tgreen-fe/so101-legs/hip_roll_v2.SLDPRT

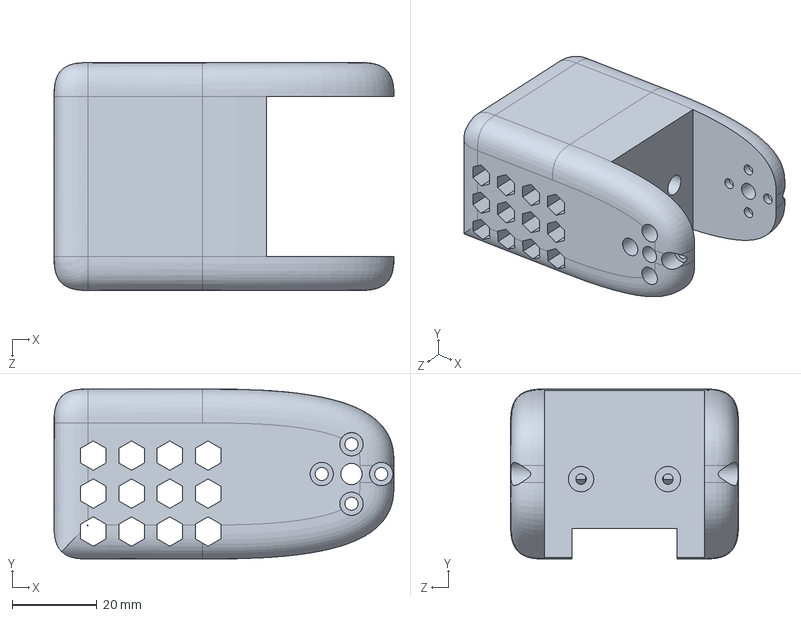
[picture p1: CAD file, 2026-09-14]
hip_roll_v2.SLDPRT
80.0 x 40.0 x 53.6 mm
