tgreen-fe/so101-legs/v3/mujoco/meshes/thigh_L_printed.stl

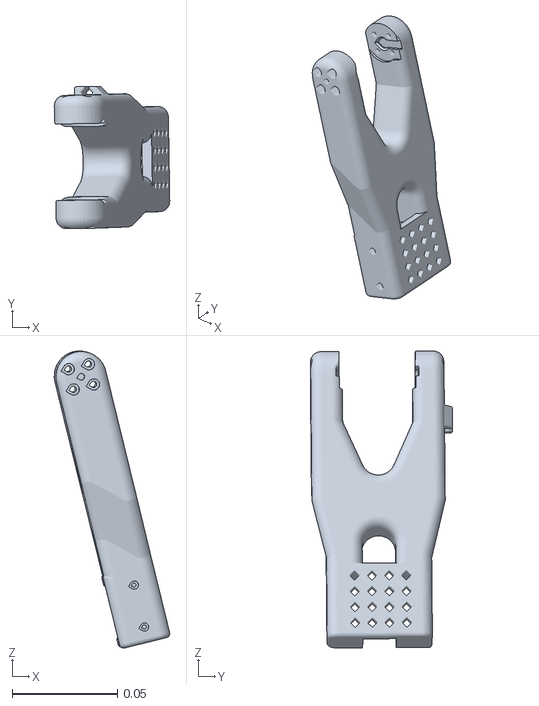
[picture p2: CAD file, 2026-11-03]
v3/mujoco/meshes/thigh_L_printed.stl
0.0549 x 0.0677 x 0.141
