tgreen-fe/so101-legs/v3/parts/leg_lower_v3.SLDPRT

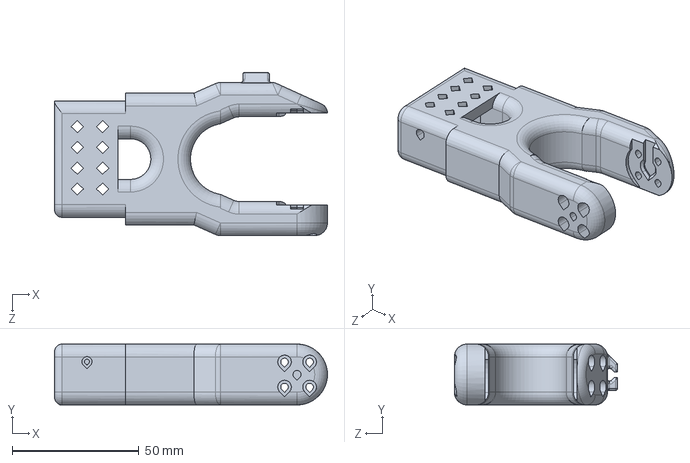
[picture p3: CAD file, 2026-11-03]
v3/parts/leg_lower_v3.SLDPRT
107.7 x 24.0 x 64.4 mm
