tgreen-fe/so101-legs/v3/pelvis_v3.SLDPRT

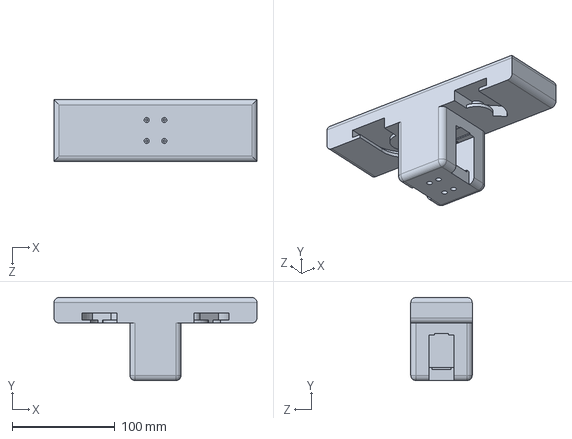
[picture p4: CAD file, 2026-11-03]
v3/pelvis_v3.SLDPRT
198.0 x 81.0 x 60.0 mm
