tgreen-fe/so101-legs/v3/stl/sim/upper_leg.STL

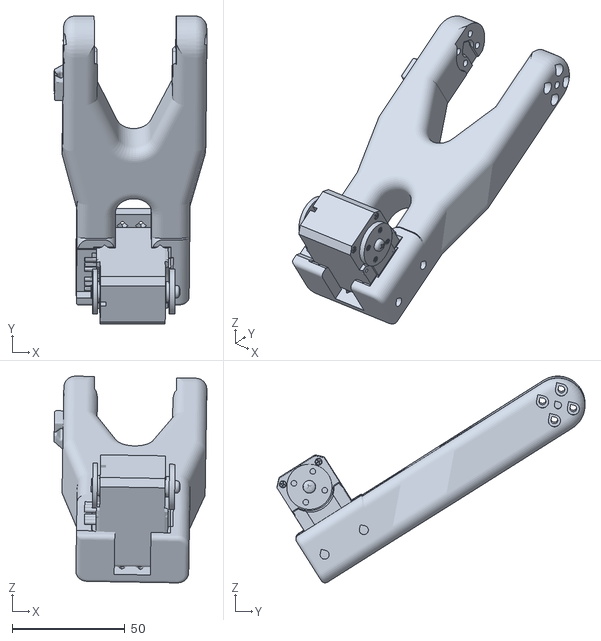
[picture p5: CAD file, 2026-11-03]
v3/stl/sim/upper_leg.STL
67.7 x 136.4 x 91.6
