tgreen-fe/so101-legs/v3/mujoco/meshes/hip_L_servo.stl

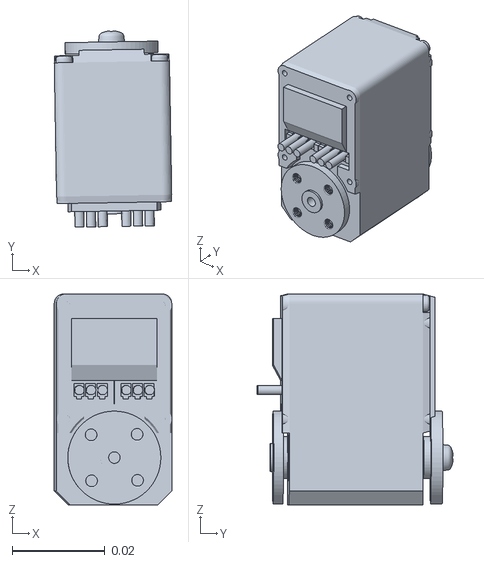
[picture p6: CAD file, 2026-11-03]
v3/mujoco/meshes/hip_L_servo.stl
0.0253 x 0.0423 x 0.0454
