tgreen-fe/so101-legs/v3/parts/hip_yaw_v3.SLDPRT

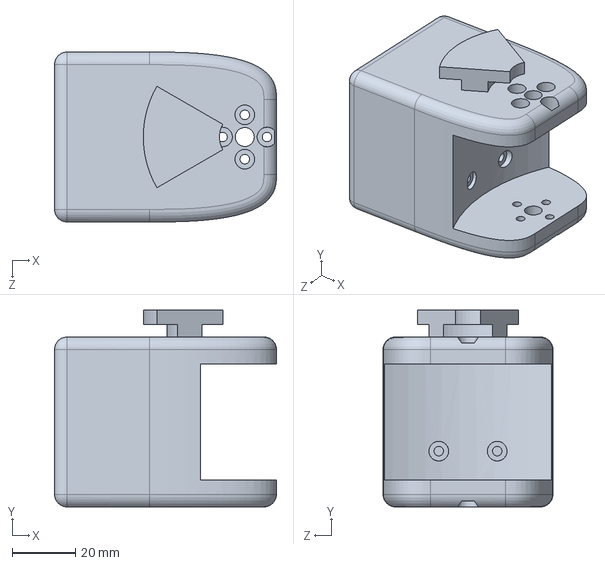
[picture p7: CAD file, 2026-11-03]
v3/parts/hip_yaw_v3.SLDPRT
70.0 x 62.1 x 53.6 mm
