tgreen-fe/so101-legs/v3/stl/sim/foot.STL

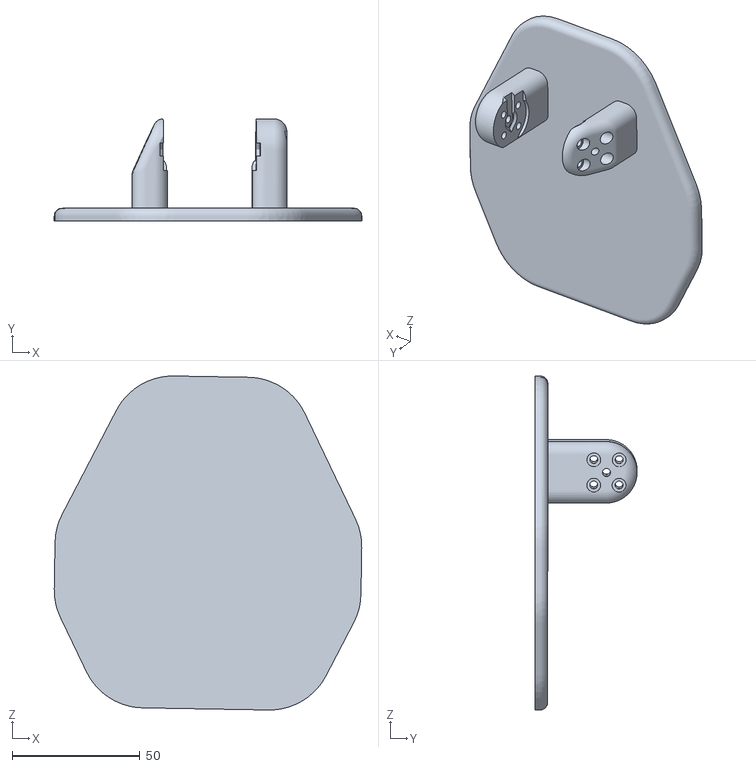
[picture p8: CAD file, 2026-11-03]
v3/stl/sim/foot.STL
120.3 x 40.0 x 130.6
