tgreen-fe/so101-legs/servo-motor_sts3215-v10.step

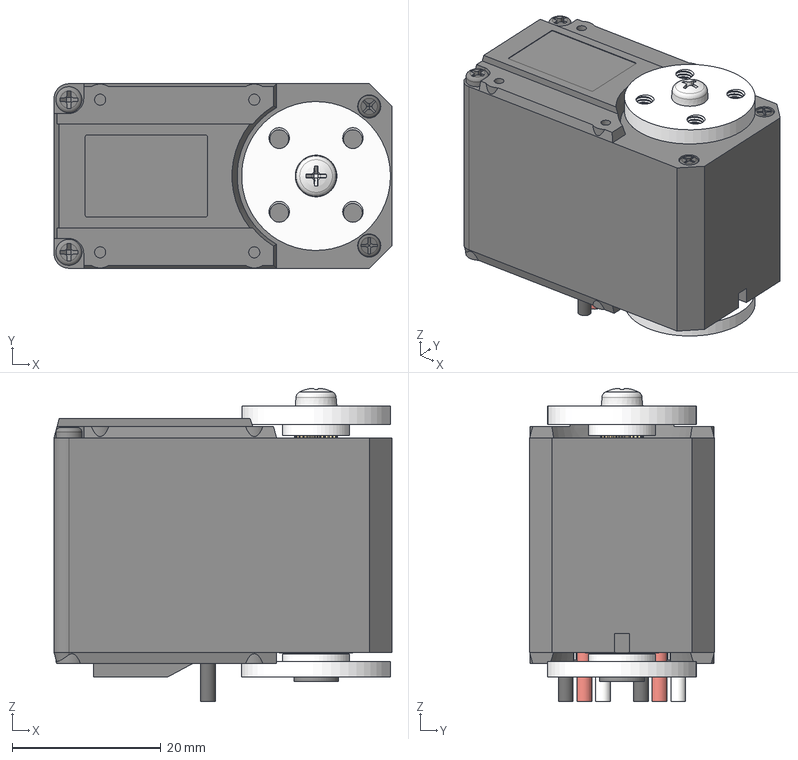
[picture p9: CAD file, 2026-09-14]
servo-motor_sts3215-v10.step
45.4 x 24.8 x 42.1 mm
Composant2
Composant3
Composant4
vis x 2
connector F x 2
PHS JIS B 1111 - M3 x 4 - H Acier inoxydable A2 Standard
