tgreen-fe/so101-legs/v3/mujoco/meshes/pelvis_servo.stl

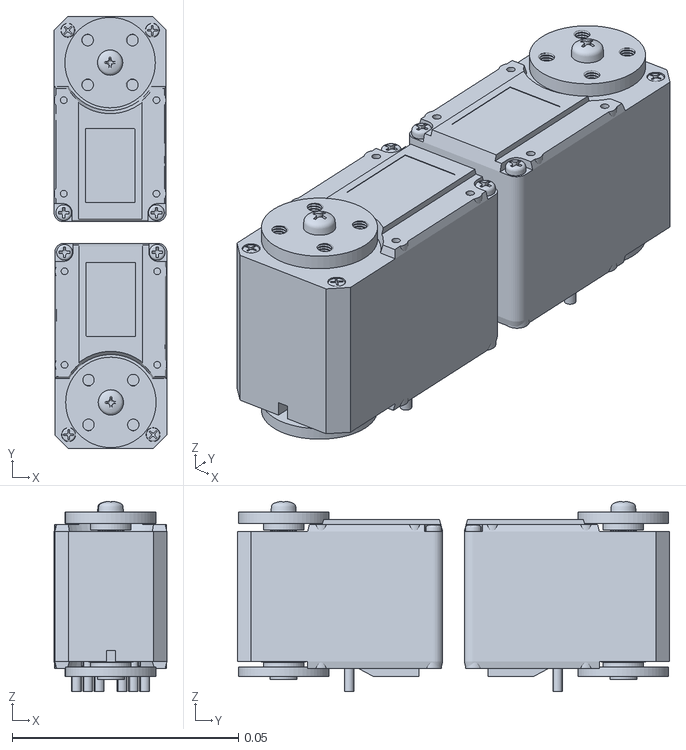
[picture p10: CAD file, 2026-11-03]
v3/mujoco/meshes/pelvis_servo.stl
0.025 x 0.0956 x 0.0421
