tgreen-fe/so101-legs/v3/stl/sim/lower_leg.STL

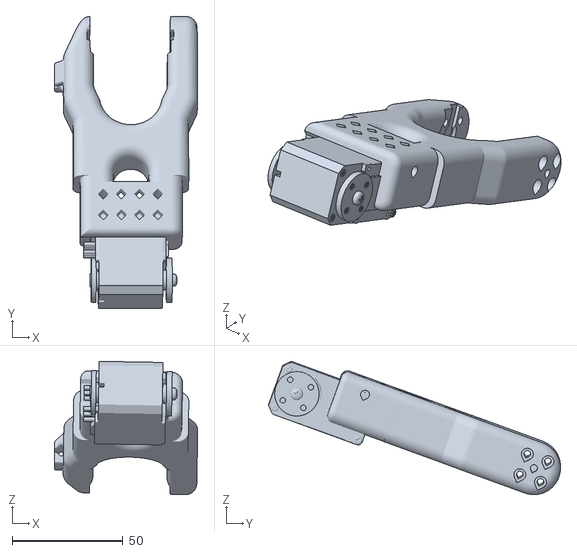
[picture p11: CAD file, 2026-11-03]
v3/stl/sim/lower_leg.STL
64.7 x 131.7 x 60.2
