tgreen-fe/so101-legs/v3/mujoco/meshes/foot_L_printed.stl

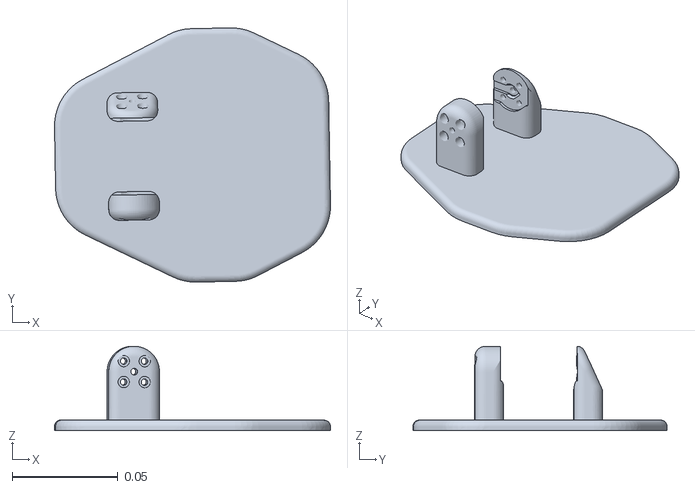
[picture p12: CAD file, 2026-11-03]
v3/mujoco/meshes/foot_L_printed.stl
0.131 x 0.12 x 0.04
