tgreen-fe/so101-legs/v3/parts/leg_upper_v3.SLDPRT

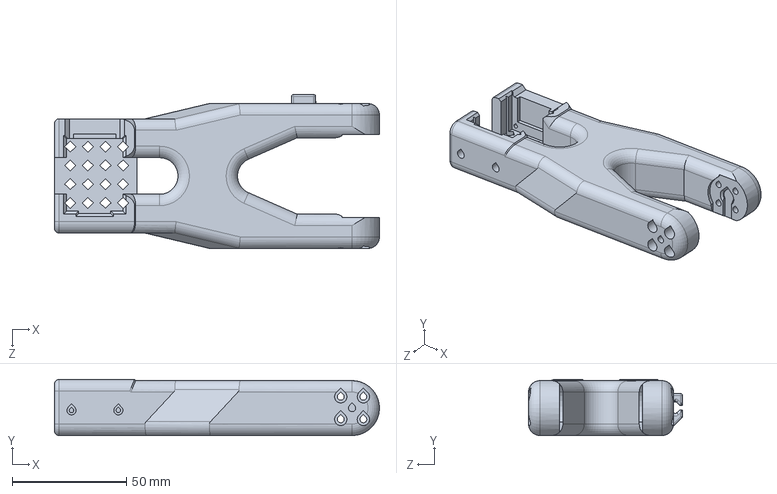
[picture p13: CAD file, 2026-11-03]
v3/parts/leg_upper_v3.SLDPRT
142.2 x 24.5 x 67.3 mm
