tgreen-fe/so101-legs/v3/stl/sim/hip.STL

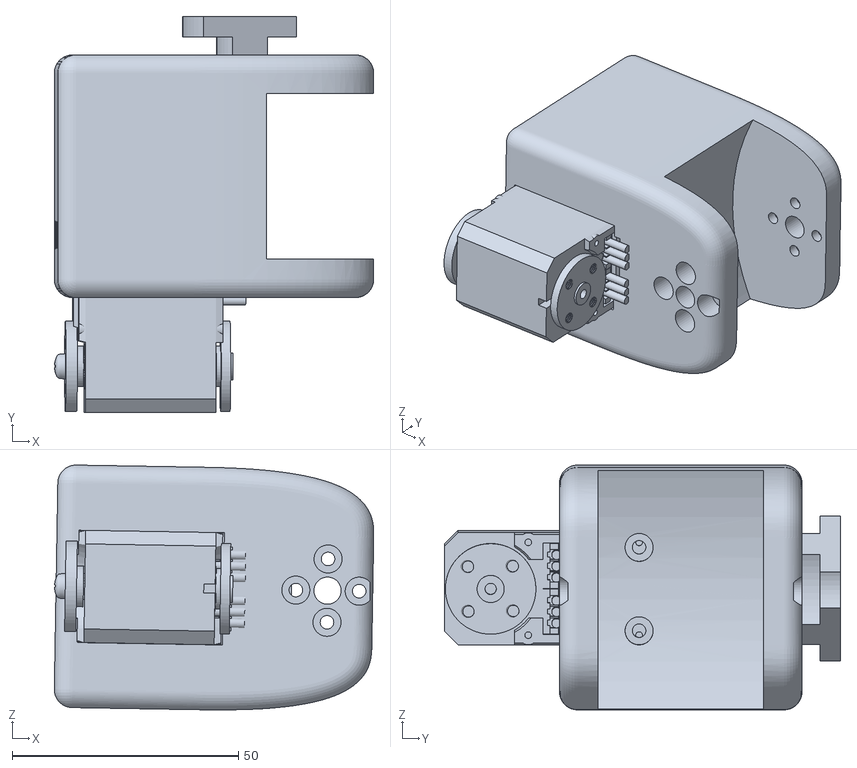
[picture p14: CAD file, 2026-11-03]
v3/stl/sim/hip.STL
70.6 x 87.5 x 54.1
