tgreen-fe/so101-legs/hip_upper_v3.SLDPRT

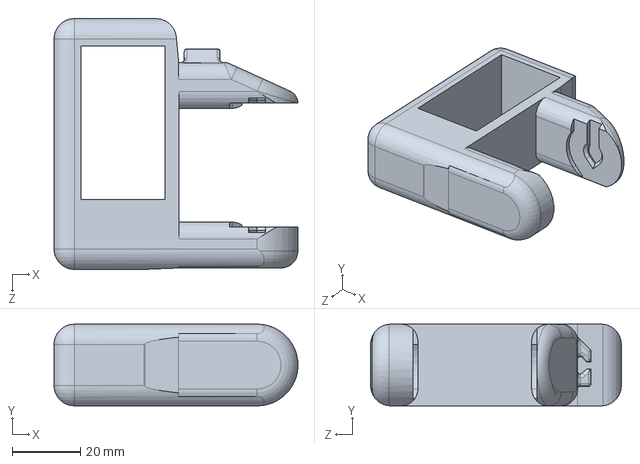
[picture p15: CAD file, 2026-09-14]
hip_upper_v3.SLDPRT
71.7 x 24.0 x 73.7 mm
