tgreen-fe/so101-legs/v3/stl/sim/pelvis.STL

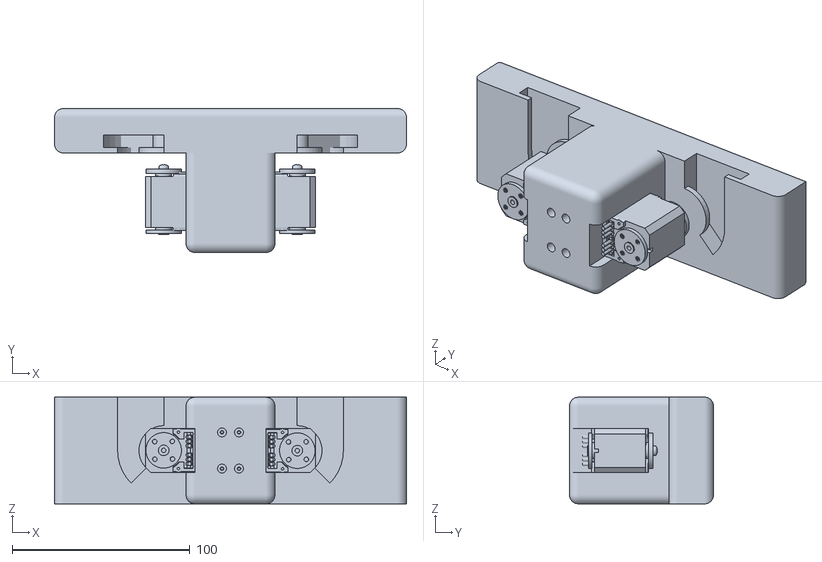
[picture p16: CAD file, 2026-11-03]
v3/stl/sim/pelvis.STL
198.0 x 81.0 x 60.0
