tgreen-fe/so101-legs/leg_lower.SLDPRT

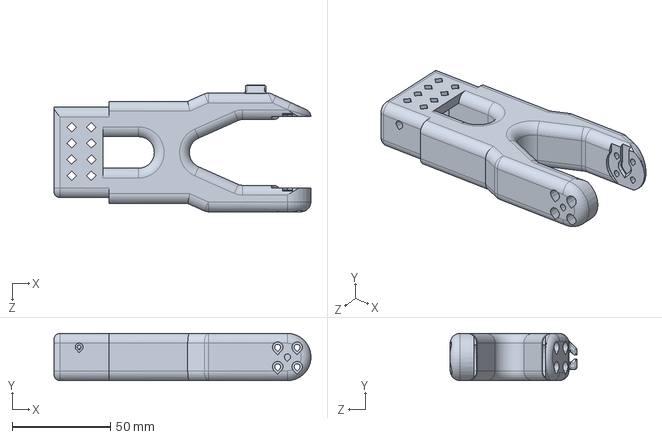
[picture p17: CAD file, 2026-09-14]
leg_lower.SLDPRT
130.7 x 24.0 x 64.4 mm
