tgreen-fe/so101-legs/hip_yaw_R.SLDPRT

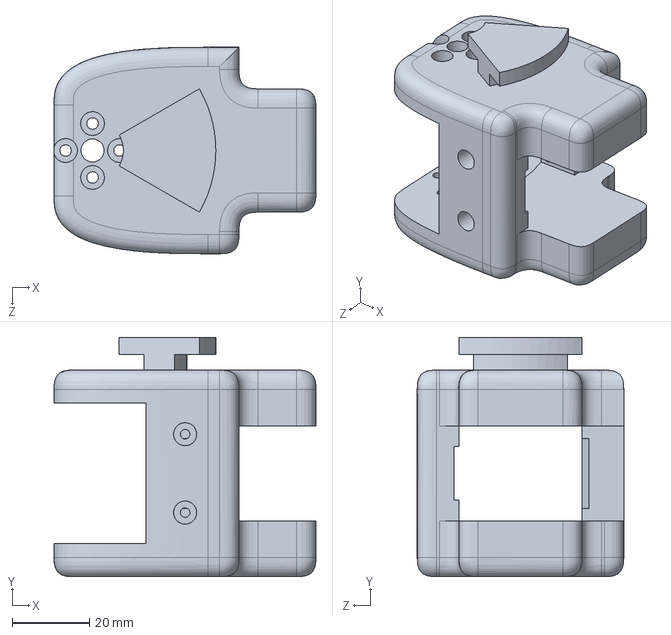
[picture p18: CAD file, 2026-09-14]
hip_yaw_R.SLDPRT
68.0 x 62.1 x 53.6 mm
