tgreen-fe/so101-legs/v3/mujoco/meshes/thigh_L_servo.stl

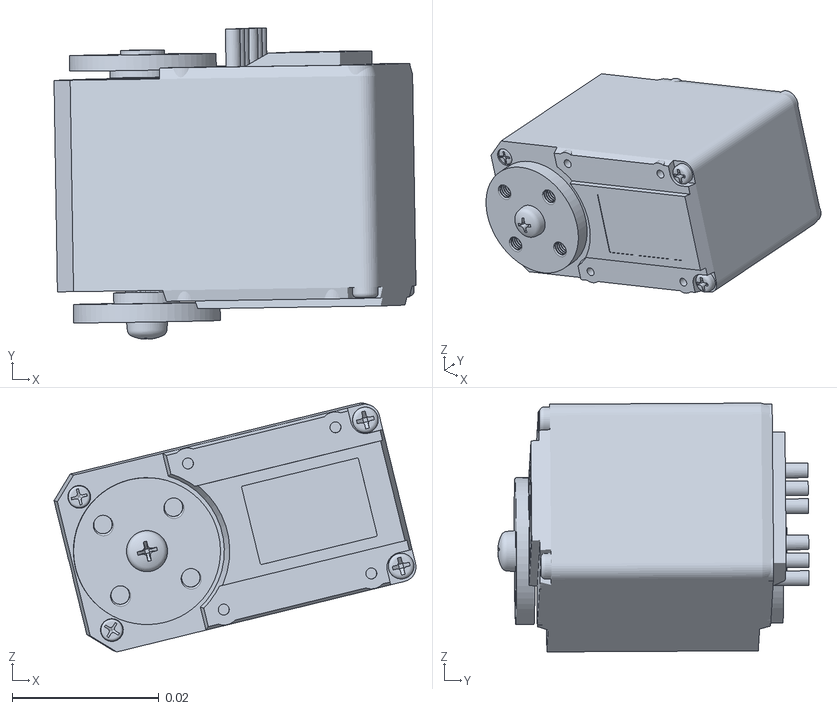
[picture p19: CAD file, 2026-11-03]
v3/mujoco/meshes/thigh_L_servo.stl
0.0493 x 0.0424 x 0.0339
