tgreen-fe/so101-legs/leg_upper_v2.SLDPRT

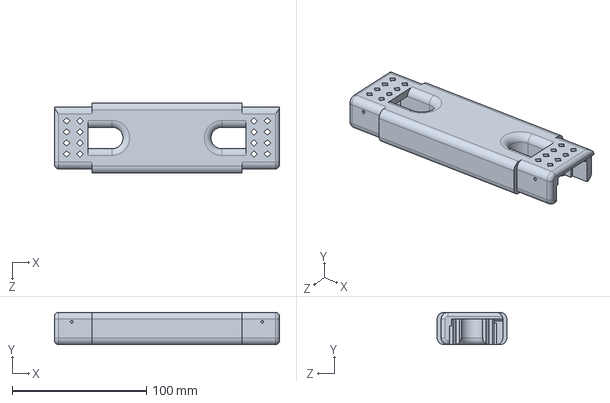
[picture p20: CAD file, 2026-09-14]
leg_upper_v2.SLDPRT
167.7 x 24.0 x 52.0 mm
