tgreen-fe/so101-legs/v3/mujoco/meshes/hip_L_printed.stl

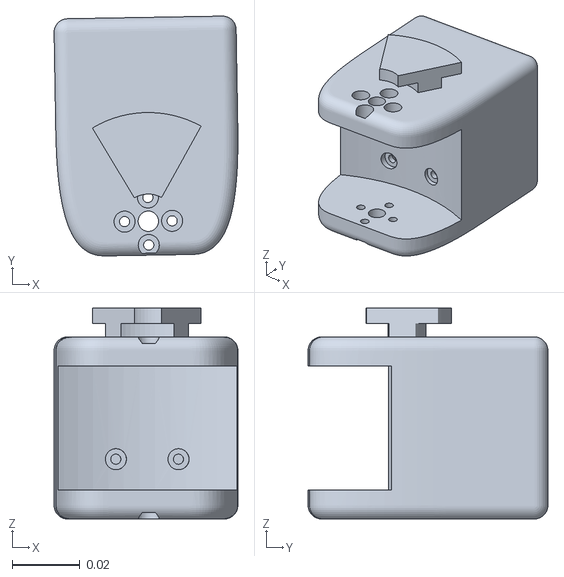
[picture p21: CAD file, 2026-11-03]
v3/mujoco/meshes/hip_L_printed.stl
0.0541 x 0.0706 x 0.0621
