tgreen-fe/so101-legs/temp_con.SLDPRT

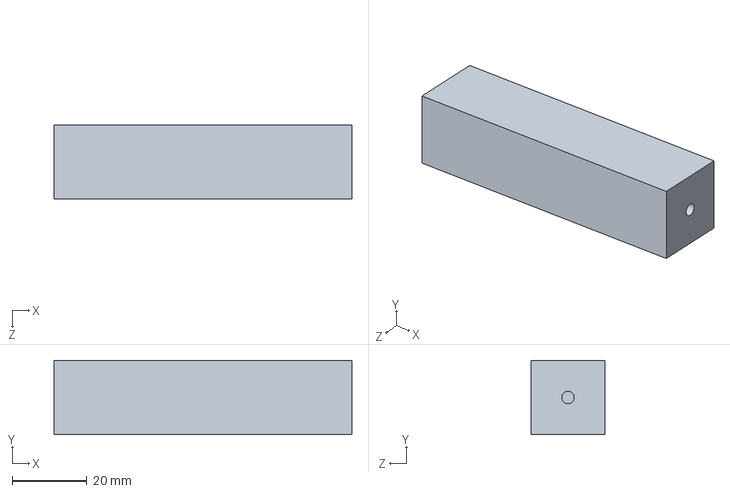
[picture p22: CAD file, 2026-09-14]
temp_con.SLDPRT
80.0 x 20.0 x 20.0 mm
