tgreen-fe/so101-legs/v3/mujoco/meshes/shank_R_servo.stl

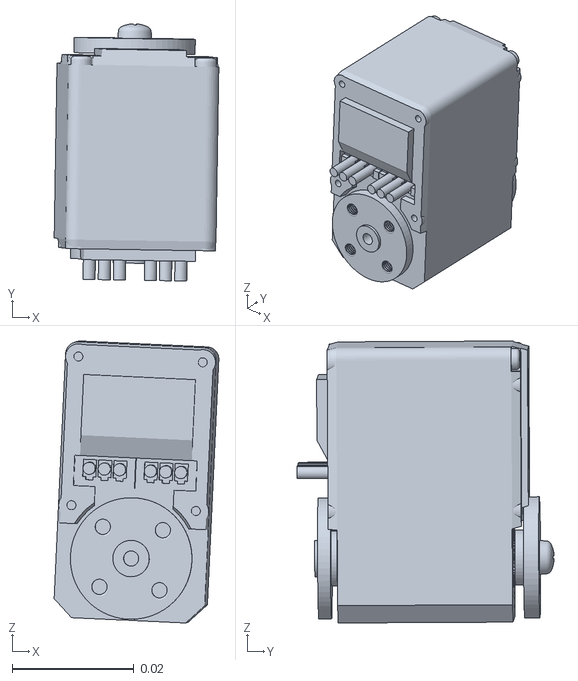
[picture p23: CAD file, 2026-11-03]
v3/mujoco/meshes/shank_R_servo.stl
0.0271 x 0.0423 x 0.0464
