tgreen-fe/so101-legs/v3/mujoco/meshes/shank_L_printed.stl

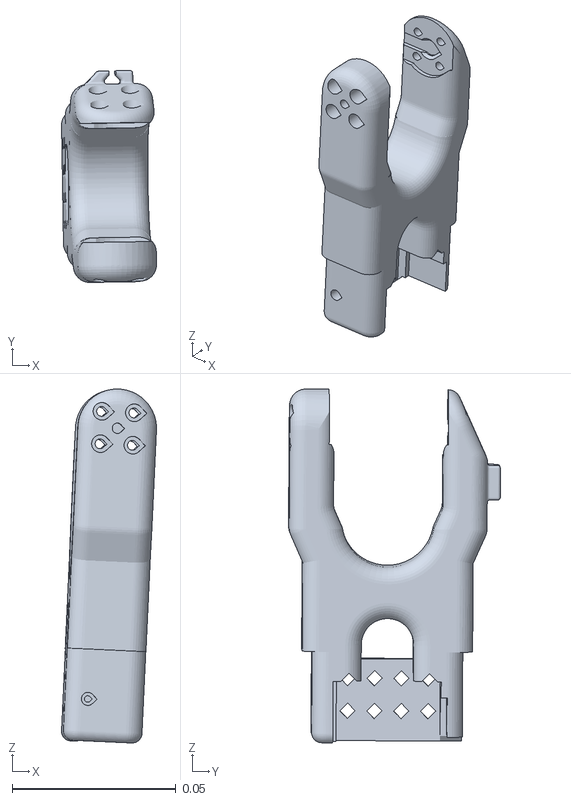
[picture p24: CAD file, 2026-11-03]
v3/mujoco/meshes/shank_L_printed.stl
0.029 x 0.0647 x 0.108
