tgreen-fe/so101-legs/hip_upper.SLDPRT

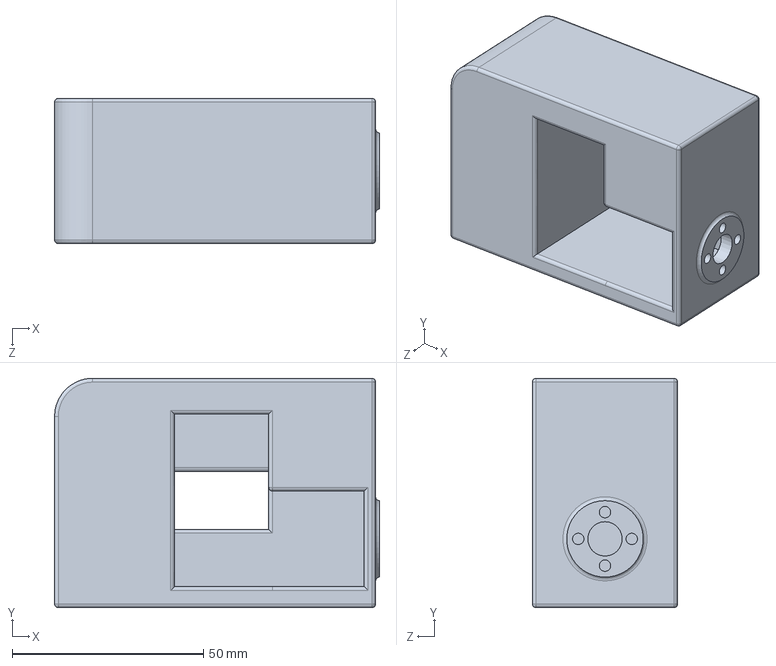
[picture p25: CAD file, 2026-09-14]
hip_upper.SLDPRT
85.0 x 60.0 x 38.0 mm
