tgreen-fe/so101-legs/knee_collar.SLDPRT

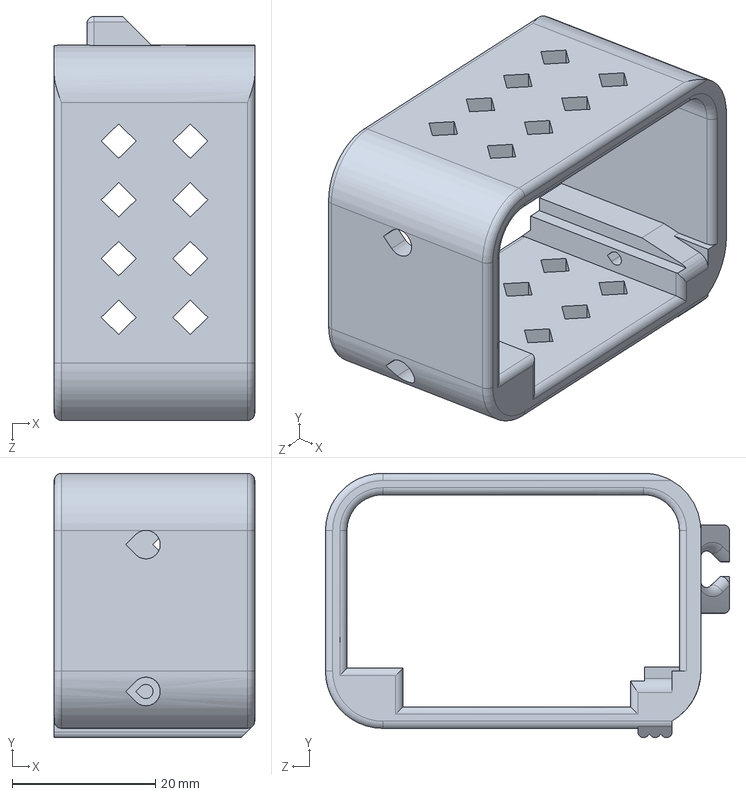
[picture p26: CAD file, 2026-09-14]
knee_collar.SLDPRT
28.0 x 36.9 x 56.4 mm
