tgreen-fe/so101-legs/v3/mujoco/meshes/pelvis_printed.stl

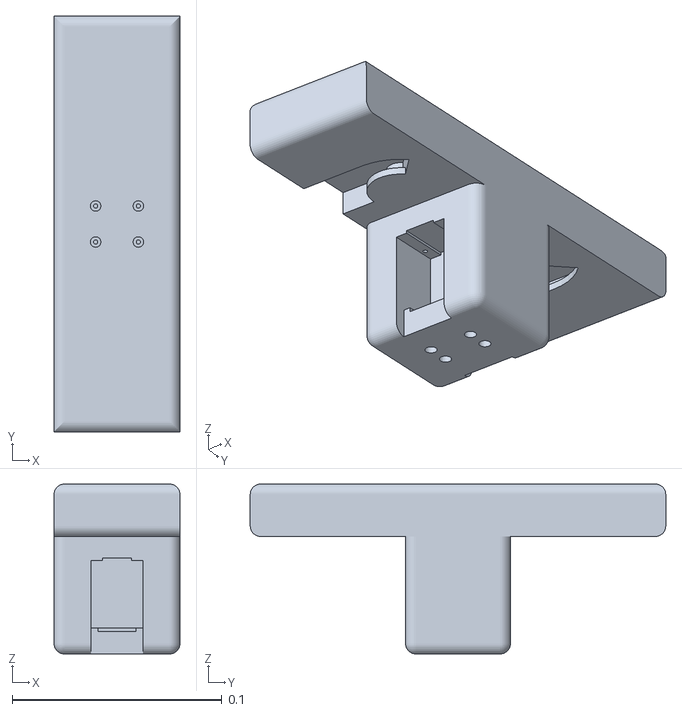
[picture p27: CAD file, 2026-11-03]
v3/mujoco/meshes/pelvis_printed.stl
0.06 x 0.198 x 0.081
