tgreen-fe/so101-legs/feet.SLDPRT

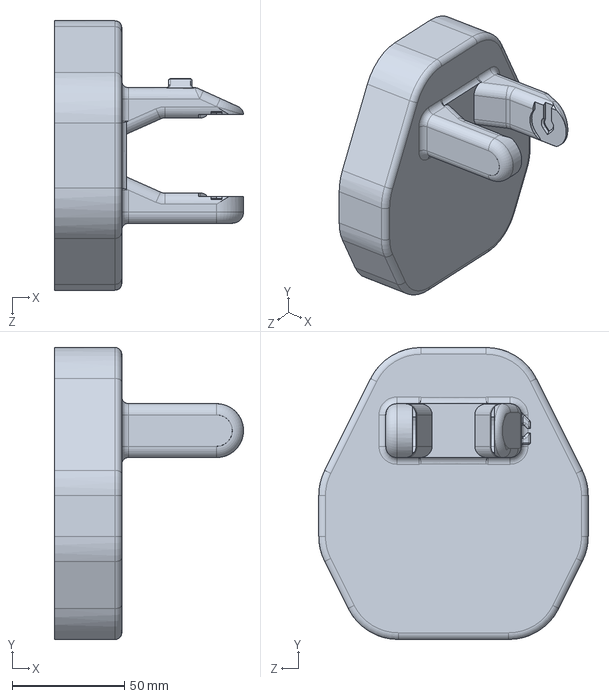
[picture p28: CAD file, 2026-09-14]
feet.SLDPRT
84.2 x 130.0 x 120.0 mm
