tgreen-fe/so101-legs/leg_upper.SLDPRT

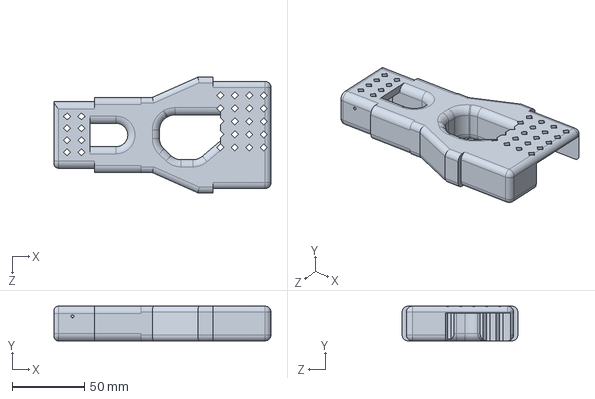
[picture p29: CAD file, 2026-09-14]
leg_upper.SLDPRT
150.0 x 24.0 x 80.0 mm
