tgreen-fe/so101-legs/leg_upper_collar.SLDPRT

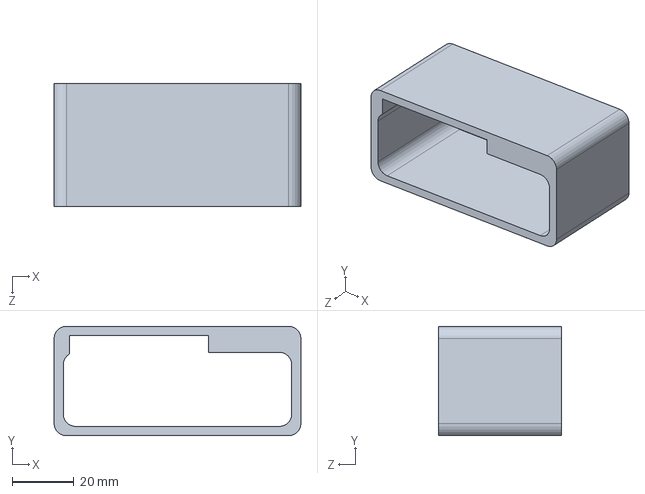
[picture p30: CAD file, 2026-09-14]
leg_upper_collar.SLDPRT
80.0 x 35.4 x 40.0 mm
