tgreen-fe/so101-legs/hip_pitch.SLDPRT

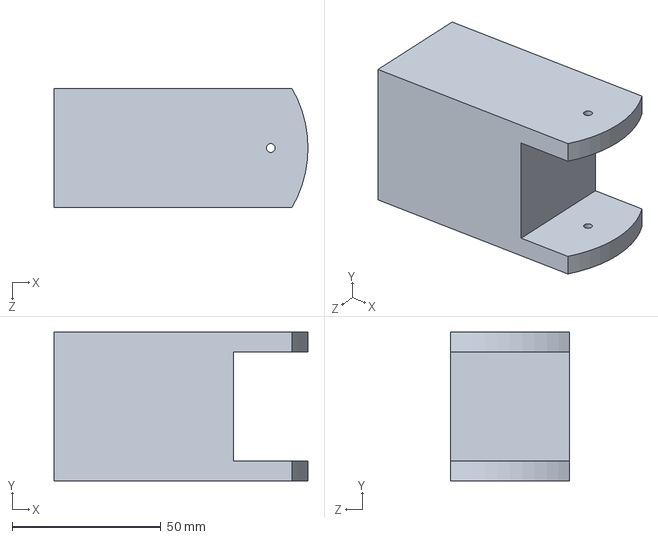
[picture p31: CAD file, 2026-09-14]
hip_pitch.SLDPRT
85.4 x 50.0 x 40.0 mm
