tgreen-fe/so101-legs/torso.SLDPRT

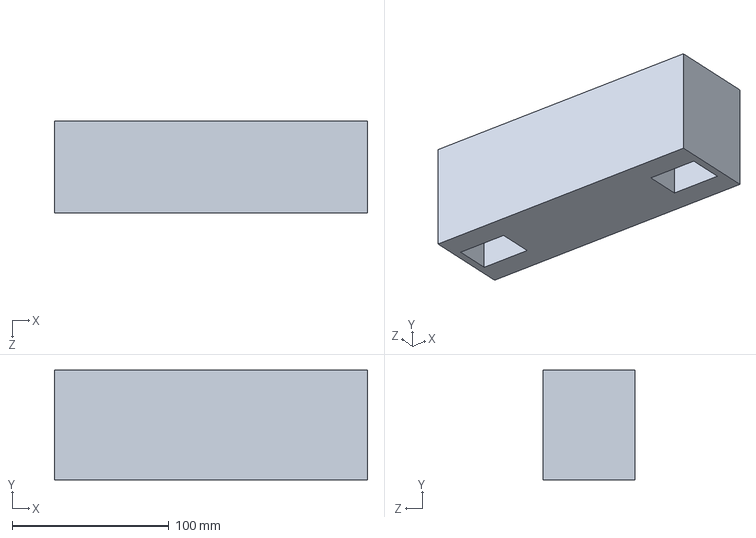
[picture p32: CAD file, 2026-09-14]
torso.SLDPRT
200.0 x 70.0 x 59.0 mm
