tgreen-fe/so101-legs/upper_con.SLDPRT

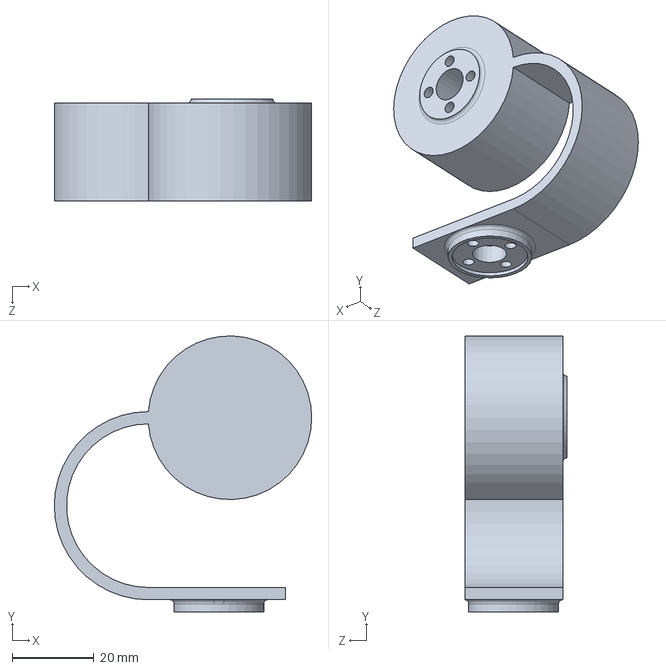
[picture p33: CAD file, 2026-09-14]
upper_con.SLDPRT
62.9 x 67.5 x 25.0 mm
