tgreen-fe/so101-legs/hip_roll.SLDPRT

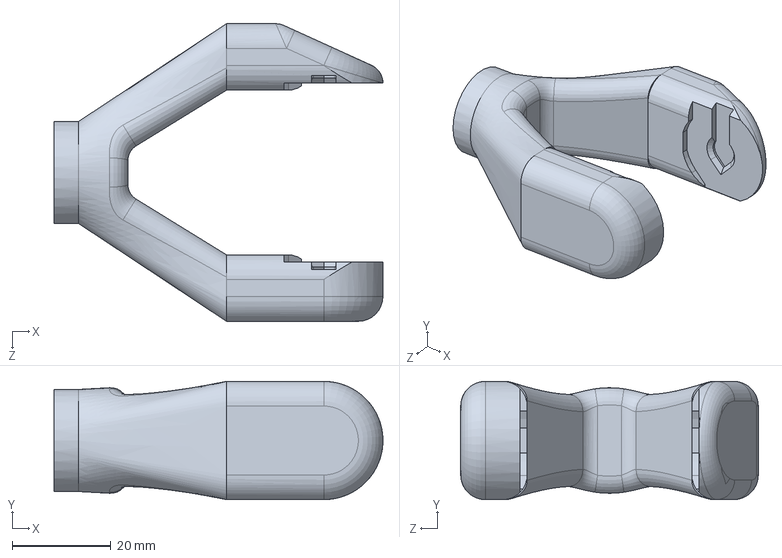
[picture p34: CAD file, 2026-09-14]
hip_roll.SLDPRT
66.8 x 24.0 x 60.4 mm
