tgreen-fe/so101-legs/feetPv2.SLDPRT

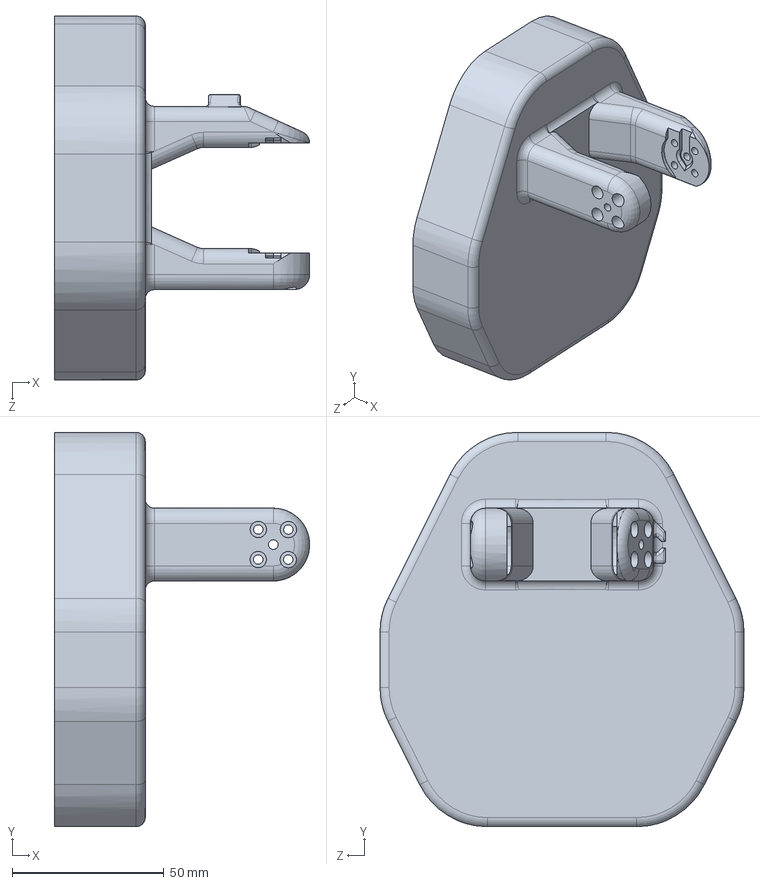
[picture p35: CAD file, 2026-09-14]
feetPv2.SLDPRT
84.2 x 130.0 x 120.0 mm
