tgreen-fe/so101-legs/pelvis.SLDPRT

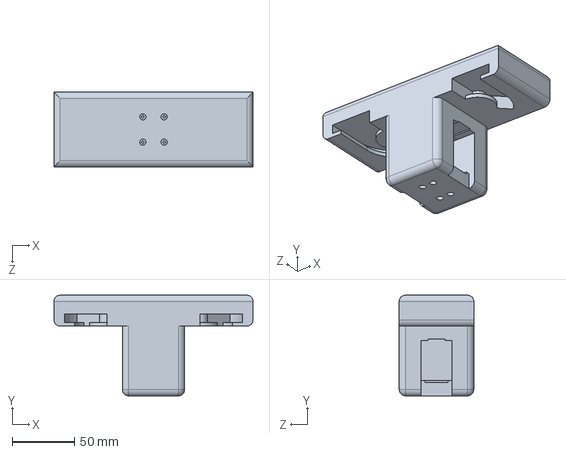
[picture p36: CAD file, 2026-09-14]
pelvis.SLDPRT
160.0 x 81.0 x 60.0 mm
