tgreen-fe/so101-legs/lower.SLDASM

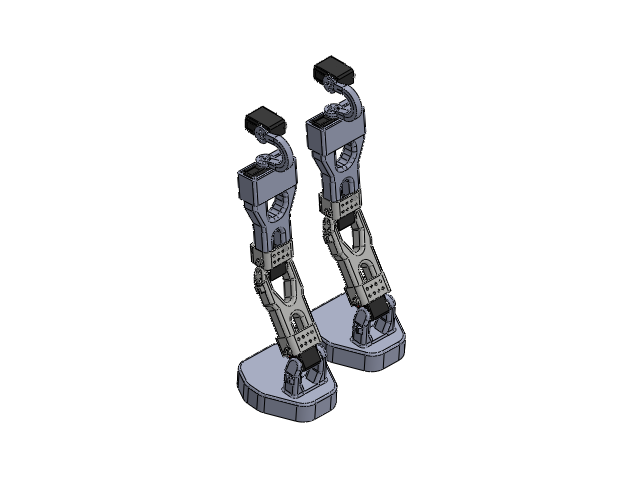
[picture p37: CAD file, 2026-09-14]
lower.SLDASM
Composant2.step x 8
Composant3.step x 8
Composant4.step x 8
vis.step x 16
connector F.step x 16
PHS JIS B 1111 - M3 x 4 - H Acier inoxydable A2 Standard.step x 8
eBom-FreeParts.step x 8
hip_upper_v2 x 2
leg_upper x 2
leg_upper_collar x 2
knee_collar x 4
leg_lower x 2
feet x 2
