tgreen-fe/so101-legs/v3/parts/legs_v3.SLDASM

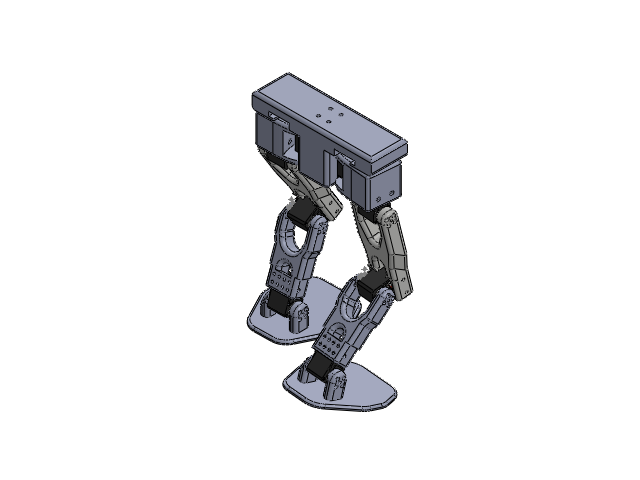
[picture p38: CAD file, 2026-11-03]
v3/parts/legs_v3.SLDASM
pelvis_v3
Composant2.step x 8
Composant3.step x 8
Composant4.step x 8
vis.step x 16
connector F.step x 16
PHS JIS B 1111 - M3 x 4 - H Acier inoxydable A2 Standard.step x 8
eBom-FreeParts.step x 8
hip_yaw_v3 x 2
leg_upper_v3 x 2
leg_lower_v3 x 2
feet_v3 x 2
