tgreen-fe/so101-legs/v3/parts/servo-motor_sts3215-v10-dim.SLDASM

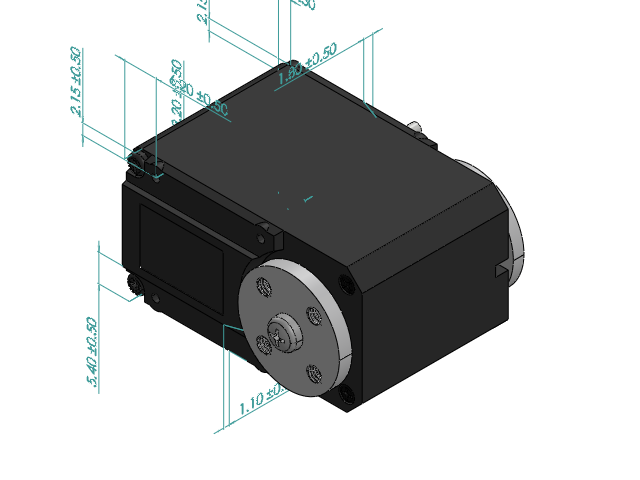
[picture p39: CAD file, 2026-11-03]
v3/parts/servo-motor_sts3215-v10-dim.SLDASM
Composant2.step
Composant3.step
Composant4.step
vis.step x 2
connector F.step x 2
PHS JIS B 1111 - M3 x 4 - H Acier inoxydable A2 Standard.step
eBom-FreeParts.step
