tgreen-fe/so101-legs/lower_assem.SLDASM

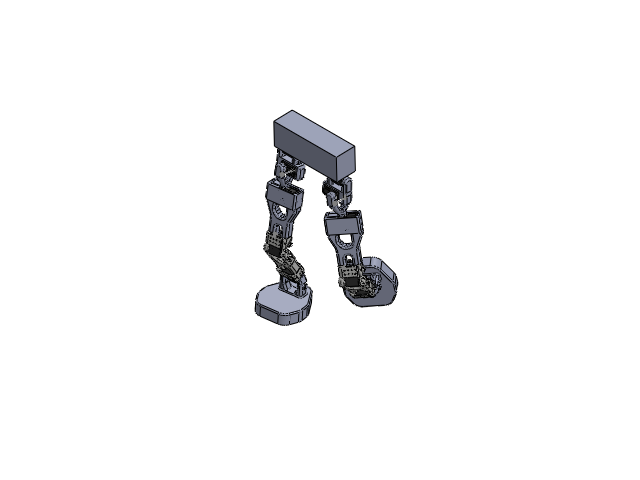
[picture p40: CAD file, 2026-09-14]
lower_assem.SLDASM
Composant2.step x 10
Composant3.step x 10
Composant4.step x 10
vis.step x 20
connector F.step x 20
PHS JIS B 1111 - M3 x 4 - H Acier inoxydable A2 Standard.step x 10
eBom-FreeParts.step x 10
leg_upper x 2
leg_upper_collar x 2
knee_collar x 4
leg_lower x 2
feet x 2
torso
hip_upper_v3 x 2
hip_roll x 2
