tgreen-fe/so101-legs/nip_v2.SLDASM

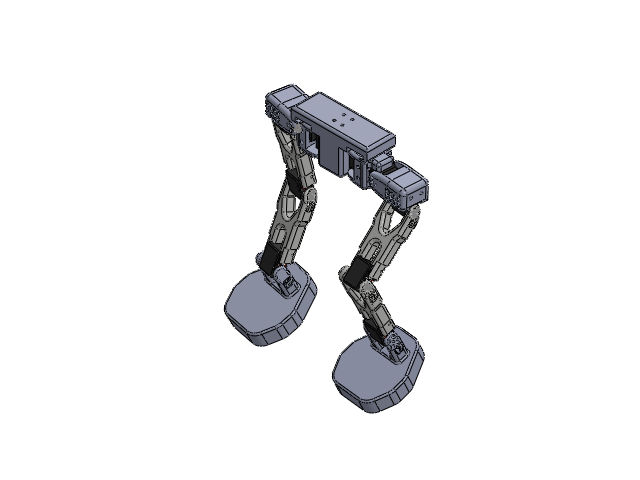
[picture p42: CAD file, 2026-09-14]
nip_v2.SLDASM
pelvis
Composant2.step x 10
Composant3.step x 10
Composant4.step x 10
vis.step x 20
connector F.step x 20
PHS JIS B 1111 - M3 x 4 - H Acier inoxydable A2 Standard.step x 10
eBom-FreeParts.step x 10
hip_yaw_L
hip_roll_v2 x 2
leg_lower_v2 x 4
feet
hip_yaw_R
feet_v2
