tgreen-fe/so101-legs/leg_assembly.SLDASM

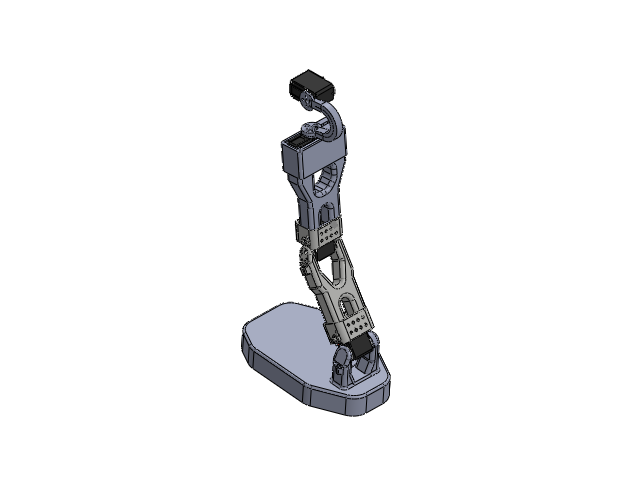
[picture p43: CAD file, 2026-09-14]
leg_assembly.SLDASM
Composant2.step x 3
Composant3.step x 3
Composant4.step x 3
vis.step x 6
connector F.step x 6
PHS JIS B 1111 - M3 x 4 - H Acier inoxydable A2 Standard.step x 3
eBom-FreeParts.step x 3
leg_upper
leg_upper_collar
knee_collar x 2
leg_lower
feet
