tgreen-fe/so101-legs/(list of files, cad)

Other CAD files:
Motor_holder_SO101_Wrist.SLDASM
v3/parts/feet_v3.SLDPRT
v3/mujoco/meshes/foot_R_printed.stl
v3/mujoco/meshes/hip_R_servo.stl
v3/mujoco/meshes/thigh_R_servo.stl
leg_lower_v2.SLDPRT
v3/mujoco/meshes/hip_R_printed.stl
v3/mujoco/meshes/shank_R_printed.stl
v3/mujoco/meshes/thigh_R_printed.stl
v3/mujoco/meshes/shank_L_servo.stl
hip_yaw_L.SLDPRT
hip_yaw.SLDPRT
feet_v2.SLDPRT
feet.STL
feet_v2.STL
hip_roll_v2.STL
hip_upper.STL
hip_upper_v2.SLDPRT
hip_yaw.STL
hip_yaw_R.STL
knee_collar.STL
leg_lower.STL
leg_upper.STL
leg_upper_collar.STL
pelvis.STL
servo-motor_sts3215-v10.SLDASM
upper_con.STL
