tgreen-fe/so101-legs/v3/mujoco/so101_legs_body.xml

<mujoco>
  <!-- Generated by build_model.py. Pelvis contents + both legs. Include inside the pelvis body. -->
  <geom class="visual_printed" mesh="pelvis_printed" mass="0.1670"/>
  <geom class="visual_servo" mesh="pelvis_servo" mass="0.1100"/>
  <geom class="collision" mesh="pelvis_printed"/>
  <site name="imu" pos="0 0 0" size="0.008" rgba="0 0.6 1 1" group="4"/>

    <body name="hip_L" pos="-5e-05 0.0376 0.0045">
      <joint name="hip_yaw_L" class="sts3215_191" axis="0 0 1" range="-0.1920 0.1571"/>
      <geom class="visual_printed" mesh="hip_L_printed" mass="0.0616"/>
      <geom class="visual_servo" mesh="hip_L_servo" mass="0.0550"/>
      <geom class="collision" mesh="hip_L_printed"/>
      <body name="thigh_L" pos="-0.00095 0.03865 -0.0582">
        <joint name="hip_pitch_L" class="sts3215_345" axis="0 1 0" range="-1.3963 1.9199"/>
        <geom class="visual_printed" mesh="thigh_L_printed" mass="0.0623"/>
        <geom class="visual_servo" mesh="thigh_L_servo" mass="0.0550"/>
        <geom class="collision" mesh="thigh_L_printed"/>
        <body name="shank_L" pos="-8.67362e-19 0 -0.116071">
          <joint name="knee_L" class="sts3215_345" axis="0 1 0" range="-0.4538 2.6180"/>
          <geom class="visual_printed" mesh="shank_L_printed" mass="0.0404"/>
          <geom class="visual_servo" mesh="shank_L_servo" mass="0.0550"/>
          <geom class="collision" mesh="shank_L_printed"/>
          <body name="foot_L" pos="2.81893e-18 0 -0.111981">
            <joint name="ankle_L" class="sts3215_345" axis="0 1 0" range="-1.6232 1.7104"/>
            <geom class="visual_printed" mesh="foot_L_printed" mass="0.0592"/>
            <geom name="foot_L" class="foot" type="box" pos="0.0278177 0.00169918 -0.0254825" size="0.0653231 0.0601458 0.00253818"/>
            <site name="foot_L" type="box" pos="0.0278177 0.00169918 -0.0280206" size="0.0683231 0.0631458 0.004" rgba="1 0 0 0.3" group="4"/>
          </body>
        </body>
      </body>
    </body>

    <body name="hip_R" pos="-5e-05 -0.0376 0.0045">
      <joint name="hip_yaw_R" class="sts3215_191" axis="0 0 1" range="-0.1571 0.1920"/>
      <geom class="visual_printed" mesh="hip_R_printed" mass="0.0616"/>
      <geom class="visual_servo" mesh="hip_R_servo" mass="0.0550"/>
      <geom class="collision" mesh="hip_R_printed"/>
      <body name="thigh_R" pos="-0.00095 -0.03865 -0.0582">
        <joint name="hip_pitch_R" class="sts3215_345" axis="0 1 0" range="-1.3963 1.9199"/>
        <geom class="visual_printed" mesh="thigh_R_printed" mass="0.0623"/>
        <geom class="visual_servo" mesh="thigh_R_servo" mass="0.0550"/>
        <geom class="collision" mesh="thigh_R_printed"/>
        <body name="shank_R" pos="-8.67362e-19 0 -0.116071">
          <joint name="knee_R" class="sts3215_345" axis="0 1 0" range="-0.4538 2.6180"/>
          <geom class="visual_printed" mesh="shank_R_printed" mass="0.0404"/>
          <geom class="visual_servo" mesh="shank_R_servo" mass="0.0550"/>
          <geom class="collision" mesh="shank_R_printed"/>
          <body name="foot_R" pos="2.81893e-18 0 -0.111981">
            <joint name="ankle_R" class="sts3215_345" axis="0 1 0" range="-1.6232 1.7104"/>
            <geom class="visual_printed" mesh="foot_R_printed" mass="0.0592"/>
            <geom name="foot_R" class="foot" type="box" pos="0.0278177 -0.00169918 -0.0254825" size="0.0653231 0.0601458 0.00253818"/>
            <site name="foot_R" type="box" pos="0.0278177 -0.00169918 -0.0280206" size="0.0683231 0.0631458 0.004" rgba="1 0 0 0.3" group="4"/>
          </body>
        </body>
      </body>
    </body>
</mujoco>
