tgreen-fe/so101-legs/(commit log)

2026-09-14 Initial commit: CAD source, STLs, servo model, README and licence
    [Motor_holder_SO101_Wrist.SLDASM, feet.SLDPRT, feet.STL, feetPv2.SLDPRT, feet_v2.SLDPRT, feet_v2.STL, hip_pitch.SLDPRT, hip_roll.SLDPRT]
2026-09-14 README: hip pitch merged into hip roll module, clearer WIP status
